keonchang88/neulbom-docker-cad/neulbom_pod/pod/sources/x1200-ups/pic1.png

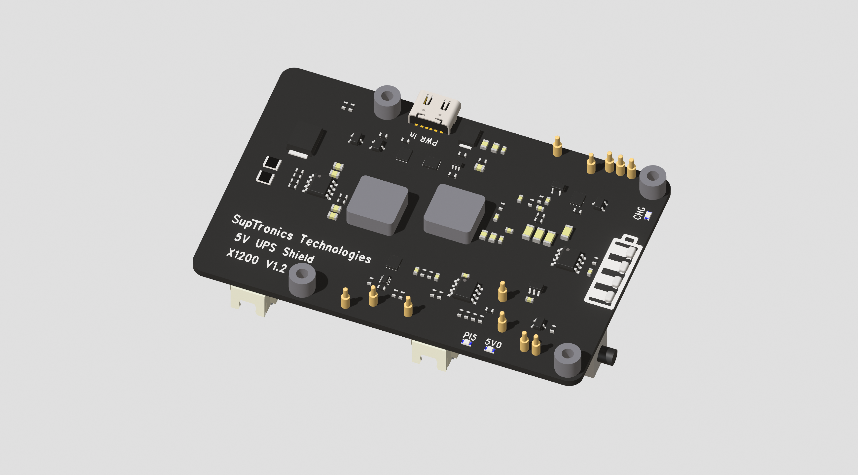
neulbom_pod/pod/sources/x1200-ups/pic1.png
