keonchang88/neulbom-docker-cad/neulbom_docker/mount/stroller_mount/stl/2_obj_BallSocket_M25x6_outer_R1p00_Top_height-Ball socket - neck top aligned with ball top (+Z).3mf

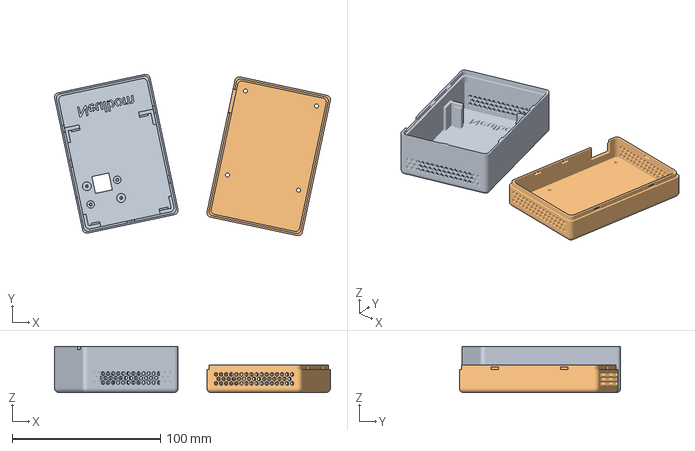
[picture p4: CAD file, 2026-11-08]
neulbom_docker/mount/stroller_mount/stl/2_obj_BallSocket_M25x6_outer_R1p00_Top_height-Ball socket - neck top aligned with ball top (+Z).3mf
186.0 x 108.8 x 31.1 mm
1_Case_Top_R3_round_copy_SideSnap_copy-Top - R3 rounded outer and mating corners.stl
2_Case_Bottom_R3_round_copy_SideSnap_copy-Bottom - R3 rounded outer and mating corners.stl
