keonchang88/neulbom-docker-cad/neulbom_docker/mount/car_mount/stl/1_obj_Pod_Clamp_Y10p6-Magnetic Pod Mount (Phone Clamp Replacement).3mf

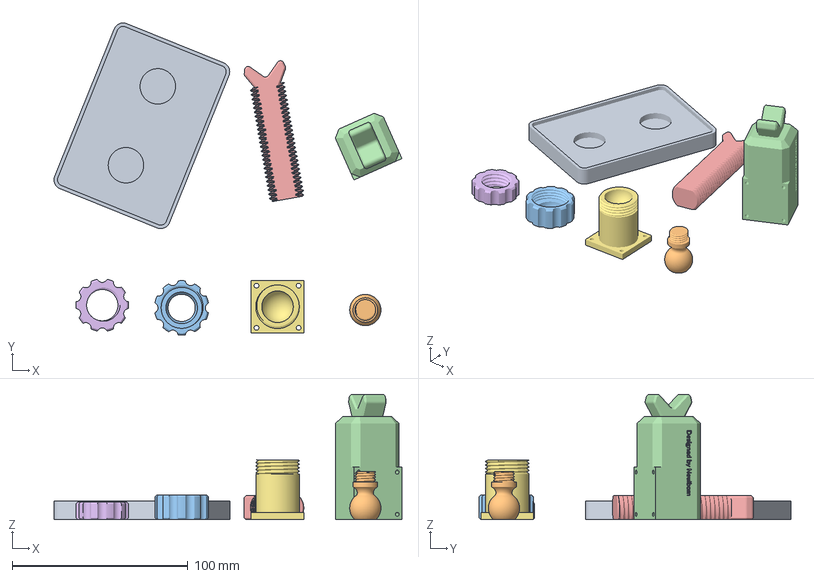
[picture p5: CAD file, 2026-11-08]
neulbom_docker/mount/car_mount/stl/1_obj_Pod_Clamp_Y10p6-Magnetic Pod Mount (Phone Clamp Replacement).3mf
198.3 x 177.8 x 71.3 mm
1_obj_Pod_Clamp_Y10p6-Magnetic Pod Mount (Phone Clamp Replacement).stl
2_obj_Pod_Clamp_Ball_Mount-Phone ball.stl
3_Ball_Nut-Ball Nut.stl
4_obj_Car_Mount_Sleeve_M2p5-Sleeve M2.5 (D2.3).stl
5_obj_Car_Mount_Rod-rod.stl
6_obj_Car_Mount_Rod_Nut-Nut.stl
7_obj_Ball_Socket_M2p5_Pillar30mm-Ball Socket M2.5 (D2.7) - Pillar 30 mm.stl
