keonchang88/neulbom-docker-cad/neulbom_pod/case/release/v4_non_ups/stl/1_Case_Top_Neulbom_x_Idea_Festival_FiveMobility_5points-Top _ Neulbom x Idea Festival _ Landscape.3mf

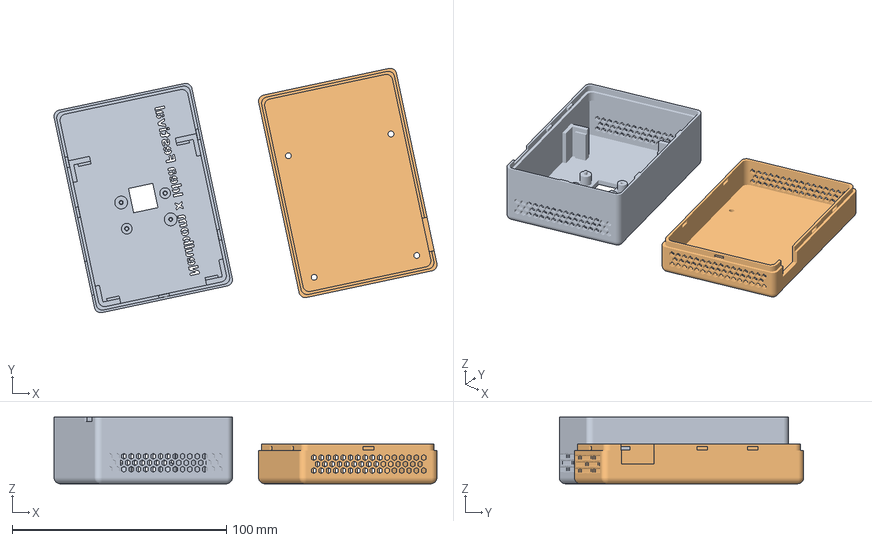
[picture p6: CAD file, 2026-11-08]
neulbom_pod/case/release/v4_non_ups/stl/1_Case_Top_Neulbom_x_Idea_Festival_FiveMobility_5points-Top _ Neulbom x Idea Festival _ Landscape.3mf
178.9 x 114.2 x 31.1 mm
1_Case_Top_Neulbom_x_Idea_Festival_FiveMobility_5points-Top _ Neulbom x Idea Festival _ Landscape.stl
2_Case_Bottom_R3_round_SideSnap_5points-Bottom - R3 rounded outer and mating corners.stl
