keonchang88/neulbom-docker-cad/neulbom_docker/mount/stroller_mount/stl/1_obj_BallMount17_M25x6_outer_R1p00-17 mm ball mount - flush bridge - plate 2.5 mm - outer edges R1.00.3mf

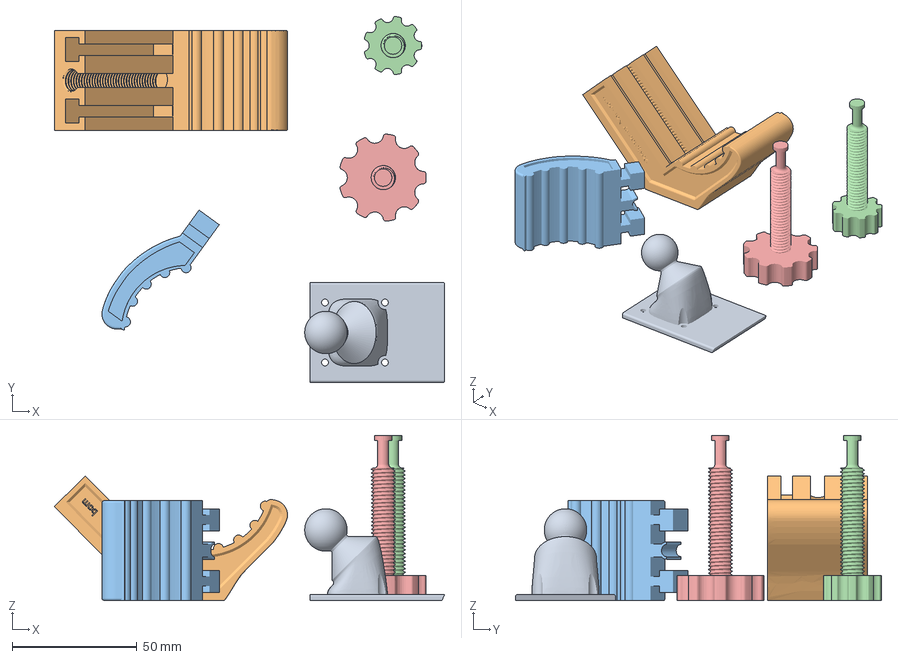
[picture p7: CAD file, 2026-11-08]
neulbom_docker/mount/stroller_mount/stl/1_obj_BallMount17_M25x6_outer_R1p00-17 mm ball mount - flush bridge - plate 2.5 mm - outer edges R1.00.3mf
156.2 x 146.4 x 66.0 mm
1_obj_BallMount17_M25x6_outer_R1p00-17 mm ball mount - flush bridge - plate 2.5 mm - outer edges R1.00.stl
3_obj_Base_M25x6_engraving_depth_0p60_smooth_border_R1p00_panels_1p20-Base - both side panels 1.20 mm - outer R1.00.stl
4_obj_Base_Slider_M25x6_symmetric_ribs_recessed_panels_R1p00_panels_1p20-Slider - both side panels 1.20 mm - outer R1.00.stl
5_obj_vite_root_R1p5_knob_2of3-Screw - R1.5 root - knob 2_3 width.stl
5_obj_vite_root_R1p5-Screw - reinforced pin root R1.5.stl
