keonchang88/neulbom-docker-cad/(list of files, cad)

Other CAD files:
assembly/NeulbomAssembly.step
neulbom_pod/case/release/v3/FCStd/Board_Camera_Assembly/Case_Board_Camera_Assemble.FCStd
neulbom_pod/case/release/v3/FCStd/R3_round_copy/SnapFit_LeadIn_proposal/Case_Assemble_R3_SnapFit_LeadIn.FCStd
assembly/DockerPodAssembly.step
neulbom_pod/case/dev/Case_dev_v1/stl_step/CaseStatic_Assembly.step
neulbom_pod/case/dev/Case_dev_v2_slide/FCstd/Case_DropSlide_Assembly_v2.FCStd
neulbom_pod/case/release/v3/FCStd/Case_Assemble_V3_release.FCStd
neulbom_pod/case/release/v3/FCStd/R3_round_copy/Case_Assemble_R3_round_copy.FCStd
neulbom_pod/case/release/v4_non_ups/FCstd/3_Case_Assemble_R3_round_copy.FCStd
assembly/PodStackAssembly.step
neulbom_docker/mount/stroller_mount/FCstd/6_stroller_mount_assembly_Top_height_matched.FCStd
neulbom_pod/case/dev/Case_dev_v2_SnapFit/FCstd/final/Case_SnapFit_Assembly_v2_final.FCStd
neulbom_pod/case/release/v4_ups/FCstd/3_Case_Assemble_SnapFit_V4_release_SideSnap_copy.FCStd
neulbom_pod/case/release/v4_non_ups/FCstd/4_Case_Assemble_V4_release.before_replace.FCStd
neulbom_pod/case/release/v4_ups/FCstd/3_Case_Assemble_SnapFit_V4_release.FCStd
neulbom_pod/pod/AIHAT_Assembly.step
neulbom_pod/case/release/v4_non_ups/FCstd/4_Case_Assemble_V4_release.before_camera_fit.FCStd
neulbom_docker/mount/car_mount/FCstd/8_Car_Mount_Assembly_Short_Rod.FCStd
neulbom_pod/case/release/v4_non_ups/FCstd/4_Case_Assemble_V4_release.before_board_lower.FCStd
neulbom_docker/mount/car_mount/FCstd/8_Car_Mount_Assembly_Long_Rod.FCStd
neulbom_pod/case/release/v4_non_ups/FCstd/4_Case_Assemble_V4_release.FCStd
neulbom_docker/mount/car_mount/FCstd/5_obj_Car_Mount_Rod.FCStd
neulbom_docker/mount/car_mount/stl/2_obj_Pod_Clamp_Ball_Mount-Phone ball.stl
neulbom_docker/mount/stroller_mount/FCstd/2_obj_BallSocket_M25x6_outer_R1p00_Top_height.FCStd
neulbom_pod/case/dev/Case_dev_v1/stl_step/neulbom_docker-body2pod.step
neulbom_pod/case/dev/Case_dev_v2_slide/FCstd/Case_Bottom_DropSlide_v2.FCStd
neulbom_pod/case/dev/Case_dev_v2_SnapFit/FCstd/final/Case_Bottom_SnapFit_v2_final.FCStd
neulbom_pod/case/dev/Case_dev_v2_SnapFit/stl/Case_Top_SnapFit_v2_Flower.stl
neulbom_pod/case/dev/Case_dev_v2_SnapFit/stl/final/Case_Top_SnapFit_v2_final_flower_engraved_reference flower line art engraved 0.5 mm.stl
neulbom_pod/case/release/v3/FCStd/Case_Bottom_SnapFit_V3_Honeycomb_Rounded.FCStd
neulbom_pod/case/release/v3/FCStd/parts/CaseStatic.FCStd
neulbom_pod/case/release/v3/FCStd/R3_round_copy/Case_Top_R3_round_copy.FCStd
neulbom_pod/case/release/v3/stl/Case_Bottom_SnapFit_V3_release-Bottom.stl
neulbom_pod/case/release/v3/stl/R3/Case_Bottom_R3_round_copy-Bottom - R3 rounded outer and mating corners.stl
neulbom_pod/case/release/v3/stl/R3_45/Case_Top_R3_SnapFit_LeadIn-Top R3 - 45deg snap lead-in proposal.stl
neulbom_pod/case/release/v4_non_ups/FCstd/1_Case_Top_Neulbom_x_Idea_Festival_FiveMobility_5points.FCStd
neulbom_pod/case/release/v4_non_ups/FCstd/parts/CaseStatic.FCStd
neulbom_pod/case/release/v4_non_ups/stl/1_Case_Top_Neulbom_x_Idea_Festival_FiveMobility_6points-Top _ Neulbom x Idea Festival _ Landscape.stl
neulbom_pod/case/release/v4_ups/FCstd/1_Case_Top_SnapFit_V4_release.FCStd
neulbom_pod/case/release/v4_ups/stl/2_Case_Bottom_SnapFit_V4_release_SideSnap_copy-Bottom V4 UPS - R3.stl
neulbom_pod/pod/Battery2.step
neulbom_pod/pod/sources/ai-hat-plus/RPiAIHATPlusBoard.stp
neulbom_pod/pod/sources/camera-module-3-step/Camera_module_3_std_model_simple.stp
neulbom_pod/pod/sources/RP_CAD_small/rpi-5b_no_graphics.step
neulbom_pod/pod/sources/x1200-ups/Geekworm X1200 UPS HAT.step
neulbom_UI/stl_step/XiaoxinPadPro127.step
neulbom_docker/mount/car_mount/FCstd/1_obj_Pod_Clamp_Y10p6.FCStd
neulbom_docker/mount/stroller_mount/FCstd/5_obj_vite_root_R1p5_knob_2of3.FCStd
neulbom_docker/mount/stroller_mount/FCstd/parts/2_obj_Pod_Clamp_Ball_Mount.FCStd
neulbom_pod/case/dev/Case_dev_v2_SnapFit/FCstd/final/Case_Top_SnapFit_v2_final.FCStd
neulbom_pod/case/dev/Case_dev_v2_SnapFit/stl/Case_Bottom_SnapFit_v2-Case Bottom.stl
neulbom_pod/case/dev/Case_dev_v2_SnapFit/stl/final/Case_Bottom_SnapFit_v2_reduced 3 mm, center fixed.stl
neulbom_pod/case/release/v3/FCStd/Board_Camera_Assembly/Case_Board_Camera_Exploded.FCStd
neulbom_pod/case/release/v3/FCStd/parts/CameraModule3_Std.FCStd
neulbom_pod/case/release/v3/FCStd/R3_round_copy/SnapFit_LeadIn_proposal/Case_Top_R3_SnapFit_LeadIn.FCStd
neulbom_pod/case/release/v3/stl/Case_Top_SnapFit_V3_release-Top.stl
neulbom_pod/case/release/v3/stl/R3/Case_Top_R3_round_copy-Top - R3 rounded outer and mating corners.stl
neulbom_pod/case/release/v3/stl/R3_45/Case_Bottom_R3_SnapFit_LeadIn-Bottom - R3 rounded outer and mating corners.stl
neulbom_pod/case/release/v4_non_ups/FCstd/parts/X1200_UPS.FCStd
neulbom_pod/case/release/v4_non_ups/stl/1_Case_Top_R3_round_SideSnap_5points-Top - R3 rounded outer and mating corners.stl
neulbom_pod/case/release/v4_ups/FCstd/1_Case_Top_SnapFit_V4_release_SideSnap_copy.FCStd
neulbom_pod/case/release/v4_ups/stl/1_Case_Top_SnapFit_V4_release_SideSnap_copy-Top V4 UPS - R3.stl
neulbom_pod/pod/Battery1.step
neulbom_pod/pod/sources/ai-hat-plus/RPiAIHATPlus.stp
neulbom_pod/pod/sources/camera-module-3-step/Camera_module_3_wide_model_simple.stp
neulbom_docker/mount/car_mount/FCstd/7_obj_Ball_Socket_M2p5_Pillar30mm.FCStd
neulbom_docker/mount/car_mount/stl/5_obj_Car_Mount_Rod-rod.stl
neulbom_docker/mount/stroller_mount/FCstd/parts/1_obj_Pod_Clamp_Y10p6.FCStd
neulbom_docker/mount/stroller_mount/stl/2_obj_BallSocket_M25x6_outer_R1p00-Ball socket - plate 2.5 mm - outer edges R1.00.stl
neulbom_pod/case/dev/Case_dev_v1/stl_step/Case_Bottom.step
neulbom_pod/case/dev/Case_dev_v2_slide/FCstd/Case_Top_DropSlide_v2.FCStd
neulbom_pod/case/dev/Case_dev_v2_SnapFit/stl/Case_Bottom_SnapFit_v2.stl
neulbom_pod/case/release/v3/FCStd/Case_Top_SnapFit_V3_release.FCStd
neulbom_pod/case/release/v3/FCStd/parts/X1200_UPS.FCStd
neulbom_pod/case/release/v3/FCStd/R3_round_copy/Case_Bottom_R3_round_copy.FCStd
neulbom_pod/case/release/v3/FCStd/R3_round_copy/SnapFit_LeadIn_proposal/Case_Bottom_R3_SnapFit_LeadIn.FCStd
neulbom_pod/case/release/v4_non_ups/FCstd/1_Case_Top_R3_round_SideSnap_4points.FCStd
neulbom_pod/case/release/v4_non_ups/FCstd/parts/RPi5.FCStd
neulbom_pod/case/release/v4_non_ups/stl/1_Case_Top_R3_round_SideSnap_4points-Top - R3 rounded outer and mating corners.stl
neulbom_pod/pod/Camera3_Std.step
neulbom_docker/mount/car_mount/stl/7_obj_Ball_Socket_M2p5_Pillar50mm-Ball Socket M2.5 (D2.7).stl
neulbom_docker/mount/stroller_mount/FCstd/3_obj_Base_M25x6_engraving_depth_0p60_smooth_border_R1p00.FCStd
neulbom_docker/mount/stroller_mount/stl/3_obj_Base_M25x6_engraving_depth_0p60_smooth_border_R1p00_panels_1p20-Base - both side panels 1.20 mm - outer R1.00.stl
neulbom_pod/case/dev/Case_dev_v1/stl_step/Case_Top.step
neulbom_pod/case/release/v3/FCStd/parts/RPi5.FCStd
neulbom_pod/case/release/v4_non_ups/FCstd/1_Case_Top_R3_round_SideSnap_6points.FCStd
neulbom_pod/case/release/v4_non_ups/FCstd/parts/CameraModule3_Std.FCStd
neulbom_pod/case/release/v4_non_ups/stl/2_Case_Bottom_R3_round_SideSnap_6points-Bottom - R3 rounded outer and mating corners.stl
neulbom_pod/case/release/v4_ups/FCstd/2_Case_Bottom_SnapFit_V4_release.FCStd
neulbom_pod/pod/UPS_X1200.step
neulbom_docker/mount/car_mount/FCstd/4_obj_Car_Mount_Sleeve_M2p5.FCStd
neulbom_docker/mount/stroller_mount/FCstd/1_obj_BallMount17_M25x6_outer_R1p00.FCStd
neulbom_docker/mount/stroller_mount/stl/4_obj_Base_Slider_M25x6_symmetric_ribs_recessed_panels_R1p00_panels_1p20-Slider - both side panels 1.20 mm - outer R1.00.stl
neulbom_pod/case/release/v3/FCStd/parts/AIHATPlus2.FCStd
neulbom_pod/case/release/v4_non_ups/FCstd/1_Case_Top_Neulbom_x_Idea_Festival_FiveMobility_6points.FCStd
neulbom_pod/case/release/v4_non_ups/FCstd/parts/AIHATPlus2.FCStd
neulbom_pod/case/release/v4_non_ups/stl/2_Case_Bottom_R3_round_SideSnap_4points-Bottom - R3 rounded outer and mating corners.stl
neulbom_pod/case/release/v4_ups/FCstd/2_Case_Bottom_SnapFit_V4_release_SideSnap_copy.FCStd
neulbom_pod/pod/RPi5.step
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
