keonchang88/neulbom-docker-cad/neulbom_pod/case/release/v3/FCStd/Board_Camera_Assembly/ASSEMBLY_NOTES.txt

조립 기준 (mm)
- 원본 케이스/부품 파일은 수정하지 않았습니다.
- 조립 파일: Case_Board_Camera_Assemble.FCStd
- 분해도: Case_Board_Camera_Exploded.FCStd (표시용 Z 간격)
- 바닥/RPi5/AI HAT 장착축: (3.5,3), (61.5,3), (3.5,52), (61.5,52).
- RPi5: 원본에서 Y=-0.5, PCB 하부 Z=0.
- 바닥 내면 Z=-3.5와 RPi5 사이에 높이 3.5의 스페이서 4개를 추가했습니다.
- AI HAT: Y=-0.5, Z=17.276. 원본 16 mm 지지대 하단이 RPi5 PCB 윗면 Z=1.276에 닿습니다.
- 카메라: X축 180도 회전, 이동 (11.5,26.5,30.5058).
- 카메라 장착축: (13.5,3.5), (26,3.5), (13.5,24.5), (26,24.5).
- 렌즈 중심: (25.9,14), +Z 방향. Top 개구부 중심과 일치합니다.
- 카메라 PCB 렌즈면 Z=31.25, Top 지지대 하단과 접촉합니다.
- 렌즈 끝 Z=38.1558, Top 외부 표면 Z=39.1: 렌즈 끝이 0.9442 mm 안쪽입니다. 외부 돌출 상태는 아닙니다.
- 간섭 검사: 바닥/보드, Top/보드, 보드/보드, 카메라/AI HAT 겹침 부피 0.
- Top/카메라 겹침 0.000219 mm³: 가져온 모델의 접촉면 정밀도 수준의 미세 겹침.
- 부품 Shape 유효성 검사 통과. 나사산, 케이블, 실제 공차, 전기적 커넥터 체결 검증은 포함하지 않습니다.
- UPS와 배터리는 이번 요청의 조립 대상에 포함하지 않았습니다.
