keonchang88/neulbom-docker-cad/(commit log)

2026-08-09 Add FreeCAD source and STL export
    [neulbom_docker.FCStd, neulbom_docker_1.stl]
2026-08-09 Add updated STL export
    [neulbom_docker_2.stl]
2026-08-09 Update FreeCAD design
    [neulbom_docker.FCStd]
2026-08-10 Add pod plate STL export
    [neulbom_docker.FCStd, neulbom_pod_plate_1.stl]
2026-08-14 add Pod step, stl and test Case model
    [AIHATPlus2.FCStd, AIHAT_Assembly.step, AIHAT_Assembly.stl, Battery1.step, Battery1.stl, Battery2.step, Battery2.stl, Camera3_Std.step]
2026-08-14 reorganize : move docker FCstd/STL into neulbom_docker
    [neulbom_docker.FCStd, neulbom_docker_1.stl, neulbom_docker_2.stl, neulbom_pod_plate_1.stl]
2026-08-19 Add magnet plate skirt pocket to Case_Bottom and docker-pod assembly
    - Case_Bottom: 7.9mm skirt with 30.4x90.4 pocket for magnet plate
    (0.2mm clearance, plate face 0.1mm proud for magnet contact),
    case height 77 -> 84.9mm
    - assembly/DockerPodAssembly: pod docked on neulbom_docker mount,
    magnets aligned (pitch 48.45), zero interference, colored STEP
    - re-export Case_Bottom stl/step and CaseStatic_Assembly.step
    [CaseStatic.FCStd, CaseStatic_Assembly.step, Case_Bottom.step, Case_Bottom.stl, DockerPodAssembly.FCStd, DockerPodAssembly.step]
2026-08-20 Add Xiaoxin Pad Pro 12.7 2025 tablet dummy model (neulbom_UI)
    [XiaoxinPadPro127.FCStd, XiaoxinPadPro127.step, XiaoxinPadPro127.stl]
2026-08-20 Add internal stack assembly STEP (RPi5+AIHAT+UPS+batteries)
    [PodStack_Assembly.step]
2026-08-20 Add ball clamp mount dummy model (stroller bar clamp ~ 17mm ball)
    [BallClampMount.FCStd, BallClampMount.step, BallClampMount.stl]
2026-08-20 Add neulbomAssembly with ball clamp docked to mount socket
    [neulbomAssembly.FCStd, neulbomAssembly.step]
2026-08-20 Unify assembly file naming to PascalCase
    [NeulbomAssembly.FCStd, NeulbomAssembly.step, PodStackAssembly.step]
2026-08-21 Rework case top: 4 stop tabs, lower camera 5mm, double lip joint, trim side vents
    - Stop tabs on all 4 HAT corner guides (was -Y corners only)
    - Camera lowered 5mm (HAT gap 11->6mm, heatsink remeasured); case top height -5mm
    - Split lip joint 3->6mm; lip breaks span full lip height over wall openings
    - Side intake slits 15->9 (3 dropped each side), bottom raised to clear lip recess
    - Case Top/Bottom/Docker Mount set 50% transparent in DockerPodAssembly view
    - STL/STEP re-exported; DockerPodAssembly/NeulbomAssembly synced
    [CaseStatic.FCStd, CaseStatic_Assembly.step, Case_Bottom.step, Case_Bottom.stl, Case_Top.step, Case_Top.stl, DockerPodAssembly.FCStd, DockerPodAssembly.step]
2026-08-23 Create case
2026-08-23 case update
    [260725 lower-body.stl, 260725 upper-body.3mf, 260725 upper-body.stl, 260725 upper-support.stl, 260728 lower-body.3mf, 260728 lower-body.gcode.3mf, 260728 lower-body.stl, 260728 upper-body.stl]
2026-08-30 Reorganize neulbom pod case designs
    [AIHATPlus2.FCStd, AIHAT_Assembly.step, AIHAT_Assembly.stl, Battery1.step, Battery1.stl, Battery2.step, Battery2.stl, Camera3_Std.step]
2026-11-08 Sync CAD designs and mount assemblies with current workspace
    [1_Case_Top_Neulbom_x_Idea_Festival_FiveMobility_5points-Top _ Neulbom x Idea Festival _ Landscape.3mf, 1_Case_Top_Neulbom_x_Idea_Festival_FiveMobility_5points-Top _ Neulbom x Idea Festival _ Landscape.stl, 1_Case_Top_Neulbom_x_Idea_Festival_FiveMobility_5points.FCStd, 1_Case_Top_Neulbom_x_Idea_Festival_FiveMobility_6points-Top _ Neulbom x Idea Festival _ Landscape.stl, 1_Case_Top_Neulbom_x_Idea_F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]
